pratapppv/DARTH-VADAR/README.md

# DARTH-VADAR
A simple ISM Band FMCW RADAR. The writeup can be found [here](https://pratapppv.github.io/DARTH-VADAR/)

Note: The pre-exported Gerber files donot contain etched copper power rail indicators.
