pratapppv/DARTH-VADAR/PCB Design Files/schematic.pdf

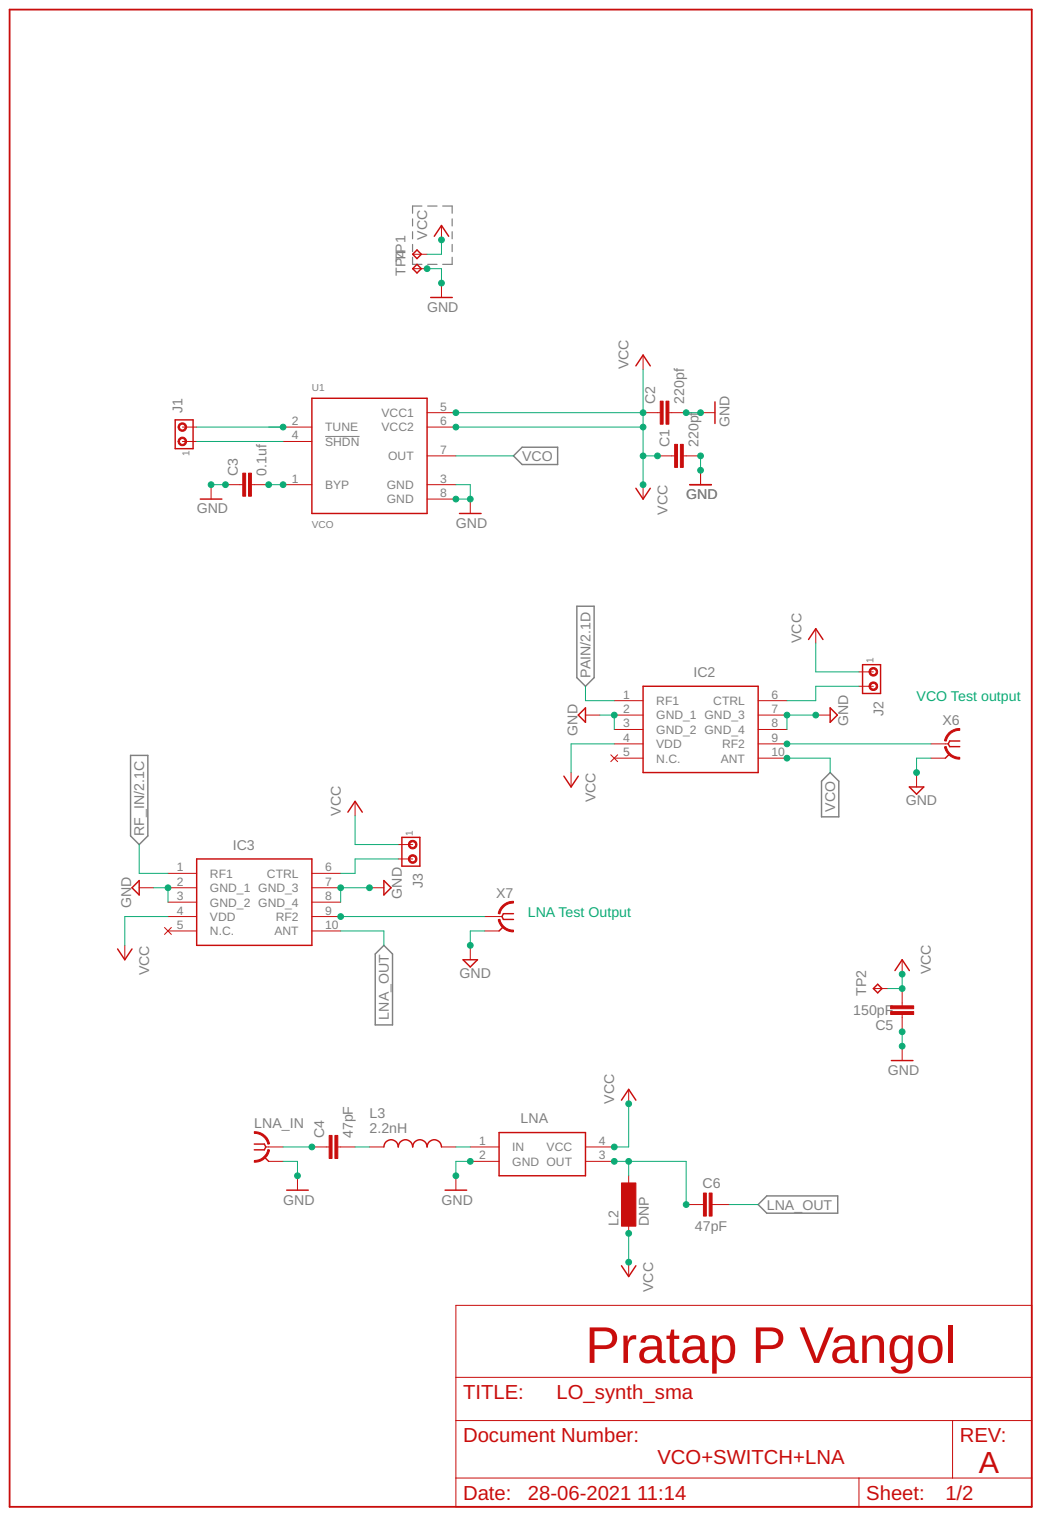
[picture p36: page 1]

5 VCC2
6 OUT 7 GND

Document Number: VCO+SWITCH+LNA | REV: A

Date: 28-06-2021 11:14 | Sheet: 1/2

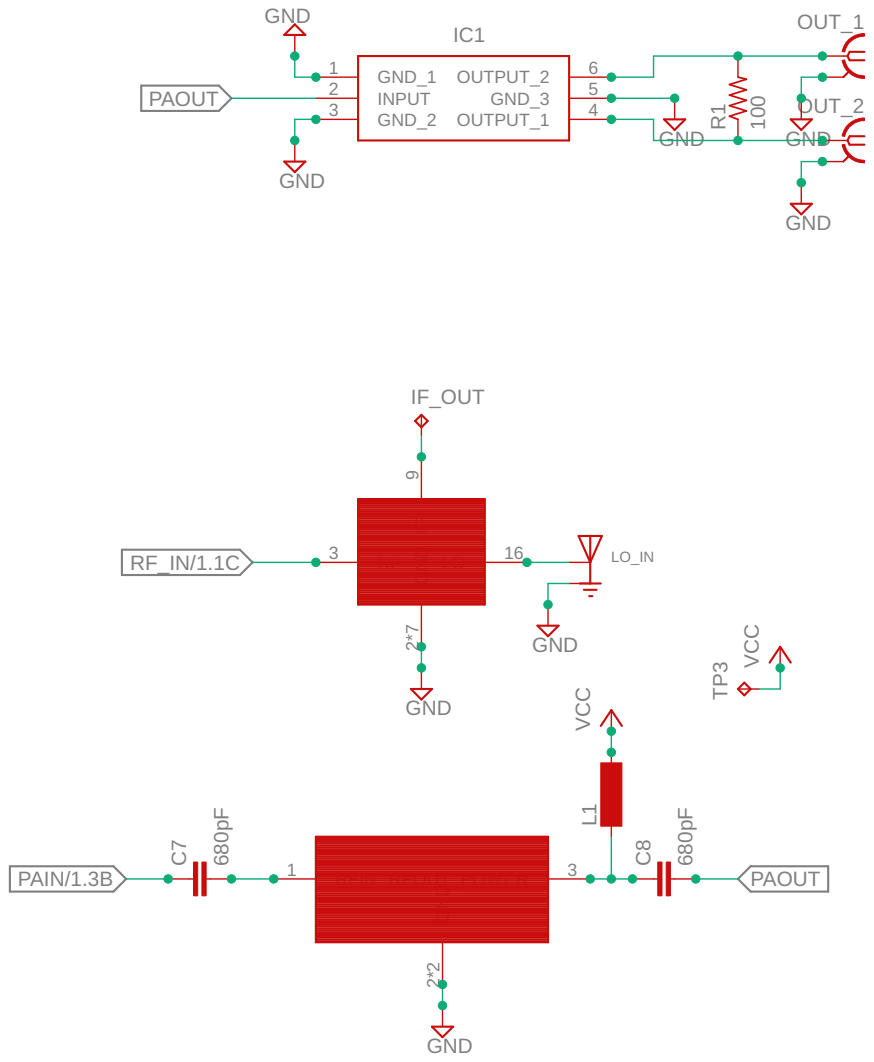
[picture p37: page 2]
