pratapppv/DARTH-VADAR/PCB Design Files/LO_synth_sma.brd

## EAGLE design PCB Design Files/LO_synth_sma.brd (2021-06-28)

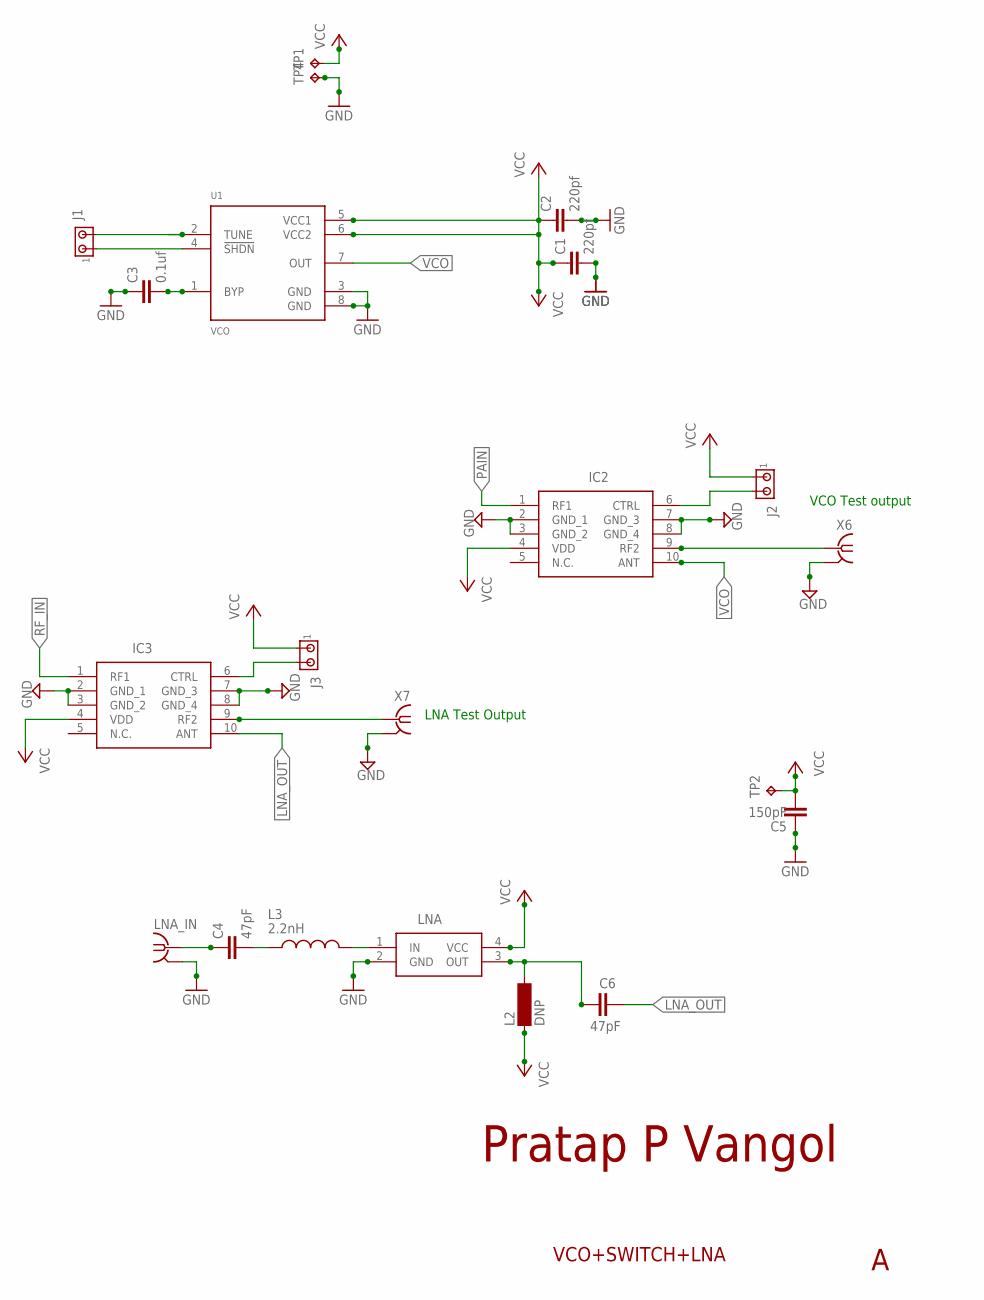
[picture p38: schematic LO_synth_sma.sch, sheet 1]

Parts:
C1, C2: 220pf; C0805
C3: 0.1uf; C0805
C4, C6: 47pF; C0805K
C5: 150pF; C0805K
IC2, IC3: BGS12PN10E6327XTSA1; BGSA11GN10E6327XTSA1
J1, J2, J3: MTA02-100; 10X02MTA
L2: DNP; MS85
L3: 2.2nH; INDC2012X103N
LNA: BGA622H6820XTSA1
LNA_IN: SMA-142-0711-821/826; J502-ND-142-0711-821/826
TP1, TP2, TP4: TPPAD1-13; P1-13
U1: VCO; SOP65P490X110-8N
X6: VCO Test; J502-ND-142-0711-821/826
X7: SMA-142-0711-821/826; J502-ND-142-0711-821/826

Connections:
GND: C1.2, C2.2, C3.1, C5.1, IC2.2 (GND_1), IC2.3 (GND_2), IC2.7 (GND_3), IC2.8 (GND_4), IC3.2 (GND_1), IC3.3 (GND_2), IC3.7 (GND_3), IC3.8 (GND_4), LNA.2 (GND), LNA_IN.G@1 (2), LNA_IN.G@2 (2), LNA_IN.G@3 (2), LNA_IN.G@4 (2), TP4.TP, U1.3 (GND), U1.8 (GND), X6.G@1 (2), X6.G@2 (2), X6.G@3 (2), X6.G@4 (2), X7.G@1 (2), X7.G@2 (2), X7.G@3 (2), X7.G@4 (2); also elsewhere on the board
LNA_OUT: C6.2, IC3.10 (ANT)
unnamed: C4.2, L3.1
unnamed: C3.2, U1.1 (BYP)
unnamed: L3.2, LNA.1 (IN)
unnamed: J1.2, U1.2 (TUNE)
unnamed: J1.1, U1.4 (!SHDN)
unnamed: C4.1, LNA_IN.1
unnamed: IC3.9 (RF2), X7.1
unnamed: C6.1, L2.2, LNA.3 (OUT)
unnamed: IC2.6 (CTRL), J2.2
unnamed: IC2.9 (RF2), X6.1
unnamed: IC3.6 (CTRL), J3.2
PAIN: IC2.1 (RF1); also elsewhere on the board
RF_IN: IC3.1 (RF1); also elsewhere on the board
VCC: C1.1, C2.1, C5.2, IC2.4 (VDD), IC3.4 (VDD), J2.1, J3.1, L2.1, LNA.4 (VCC), TP1.TP, TP2.TP, U1.5 (VCC1), U1.6 (VCC2); also elsewhere on the board
VCO: IC2.10 (ANT), U1.7 (OUT)

Notes on the sheet:
Pratap P Vangol
VCO Test output
LNA Test Output
VCO+SWITCH+LNA

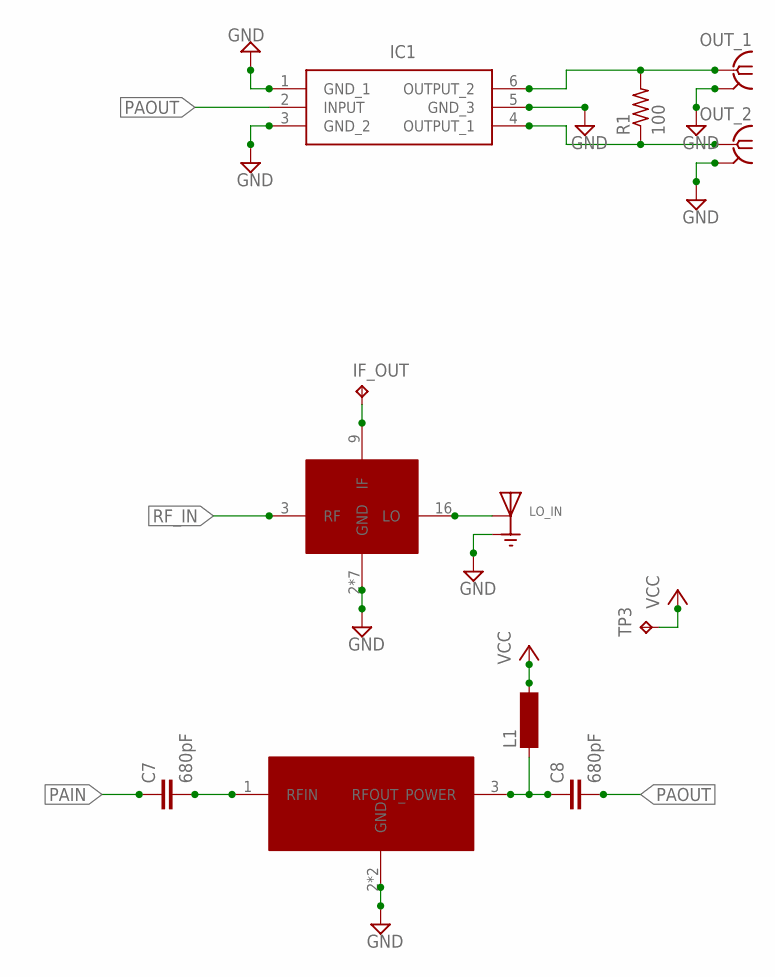
[picture p39: schematic LO_synth_sma.sch, sheet 2]

Parts:
C7, C8: 680pF; C0805K
IC1: PD2425J5050S2HF
IF_OUT: TPPAD1-13; P1-13
L1: MS85
LO_IN: U.FL-R-SMT-1(10); HRS_U.FL-R-SMT-1(10)
OUT_1, OUT_2: SMA-142-0711-821/826; J502-ND-142-0711-821/826
R1: 100; R0603
TP3: TPPAD1-13; P1-13
U$1: MDB-73H+QFN-24; QFN24
U$2: GVA-60+; SOT89

Connections:
GND: IC1.1 (GND_1), IC1.3 (GND_2), IC1.5 (GND_3), LO_IN.1 (GND), LO_IN.3 (GND), OUT_1.G@1 (2), OUT_1.G@2 (2), OUT_1.G@3 (2), OUT_1.G@4 (2), OUT_2.G@1 (2), OUT_2.G@2 (2), OUT_2.G@3 (2), OUT_2.G@4 (2), U$1.2 (GND), U$1.4 (GND), U$1.8 (GND), U$1.10 (GND), U$1.15 (GND), U$1.17 (GND), U$1.PD (GND), U$2.2 (GND), U$2.2@1 (GND); also elsewhere on the board
LO: LO_IN.2 (SIG), U$1.16 (LO)
unnamed: IF_OUT.TP, U$1.9 (IF)
unnamed: C7.2, U$2.1 (RFIN)
unnamed: C8.1, L1.1, U$2.3 (RFOUT_POWER)
unnamed: IC1.6 (OUTPUT_2), OUT_1.1, R1.2
unnamed: IC1.4 (OUTPUT_1), OUT_2.1, R1.1
PAIN: C7.1; also elsewhere on the board
PAOUT: C8.2, IC1.2 (INPUT)
RF_IN: U$1.3 (RF); also elsewhere on the board
VCC: L1.2, TP3.TP; also elsewhere on the board

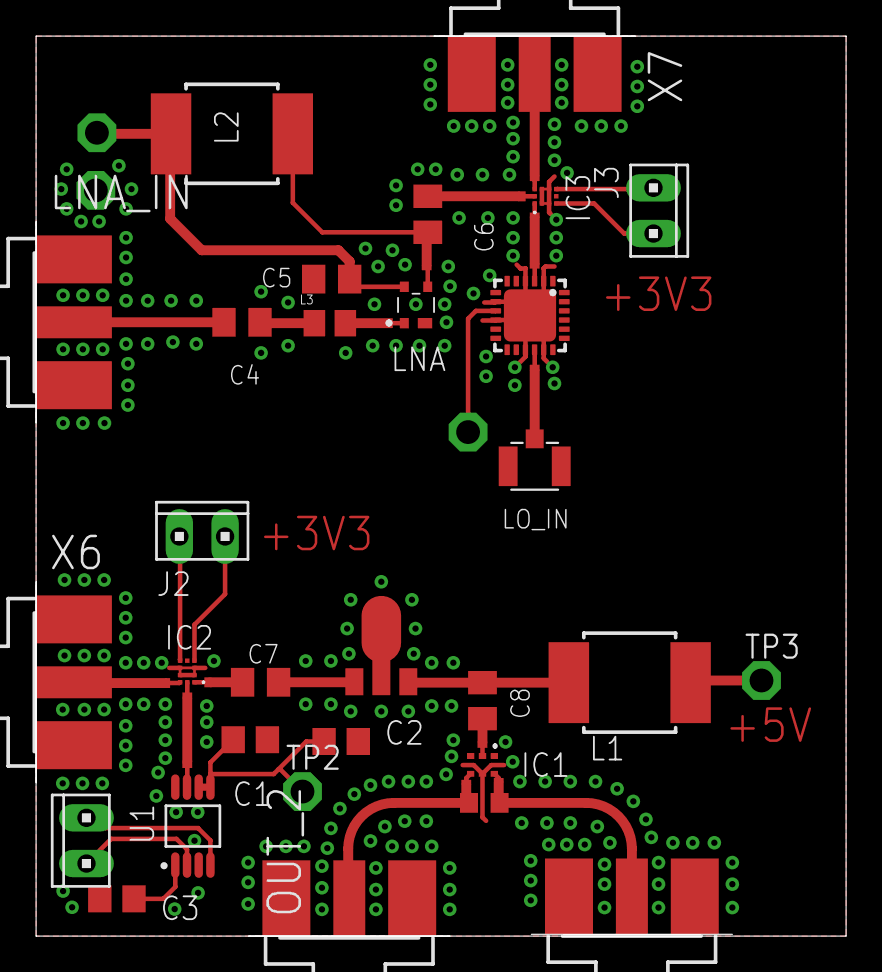
[picture p40: board LO_synth_sma.brd from above]

Board: 2 copper layers, 45.0 x 50.0 mm, 33 parts (0 on the bottom side), 24 nets.
